meerstern/STM32_Nucleo144_Memory_Shield/img/img4.jpg

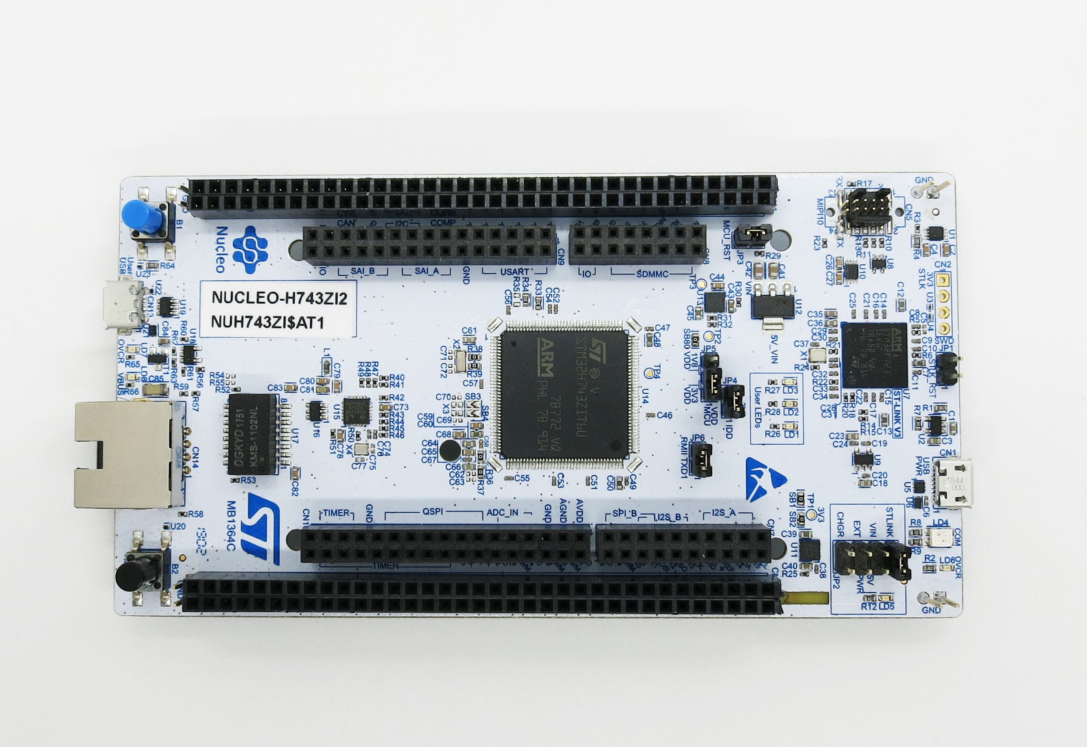
img/img4.jpg
