meerstern/STM32_Nucleo144_Memory_Shield/img2.jpg

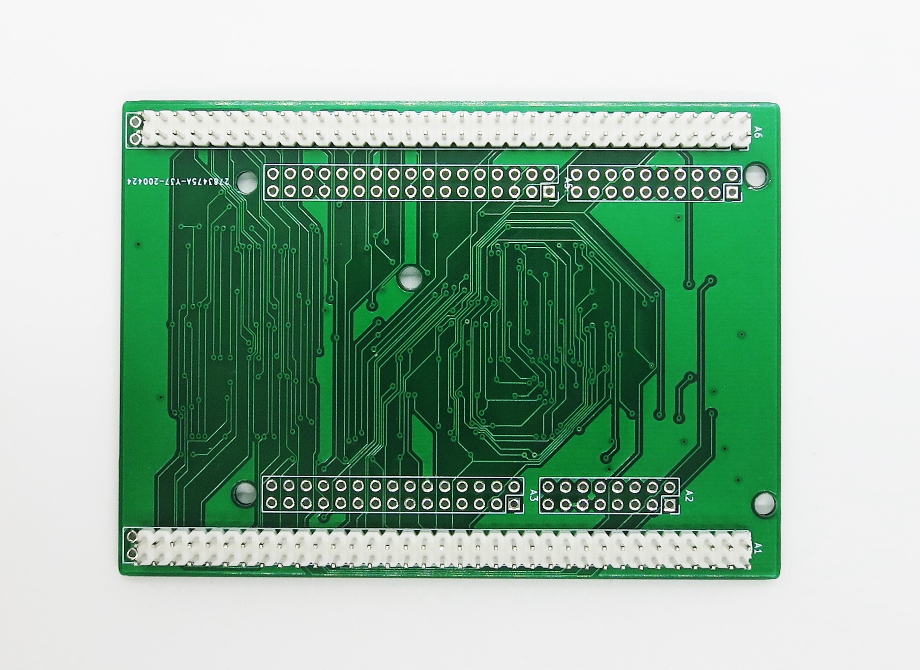
img2.jpg
