meerstern/STM32_Nucleo144_Memory_Shield/img1.jpg

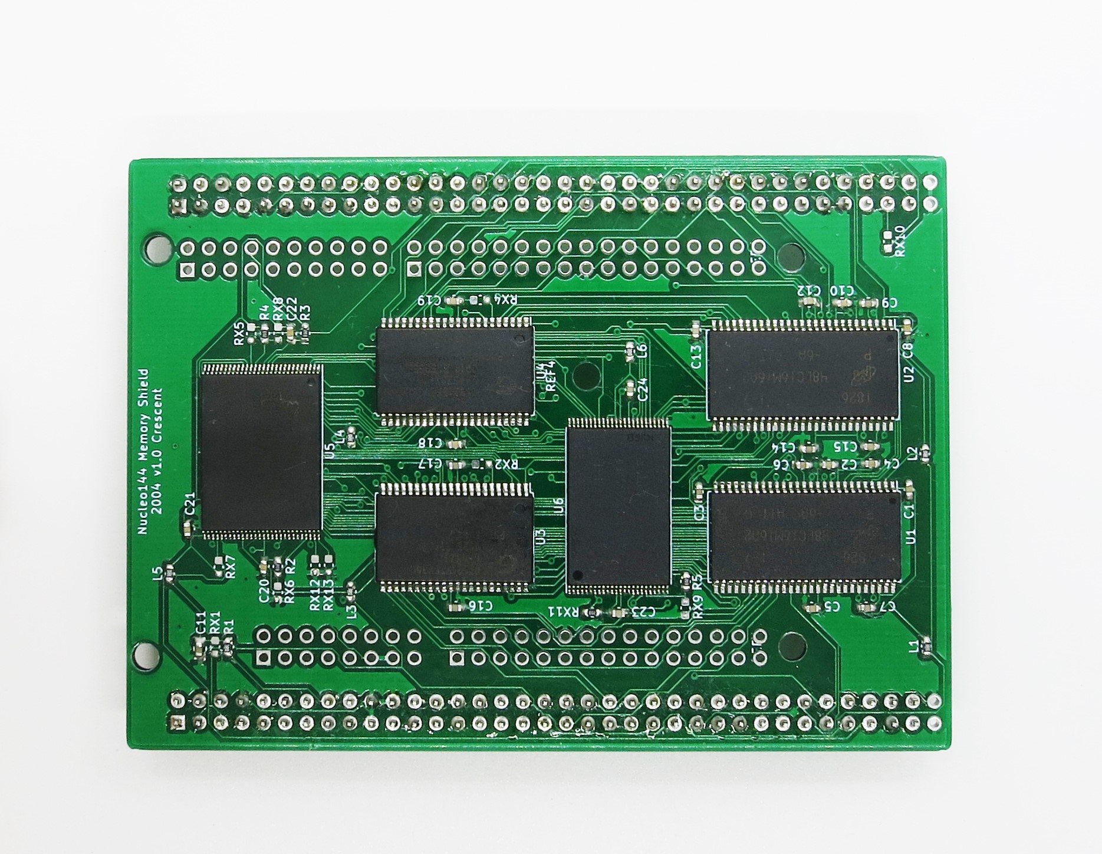
img1.jpg
