meerstern/STM32_Nucleo144_Memory_Shield/img/img1.jpg

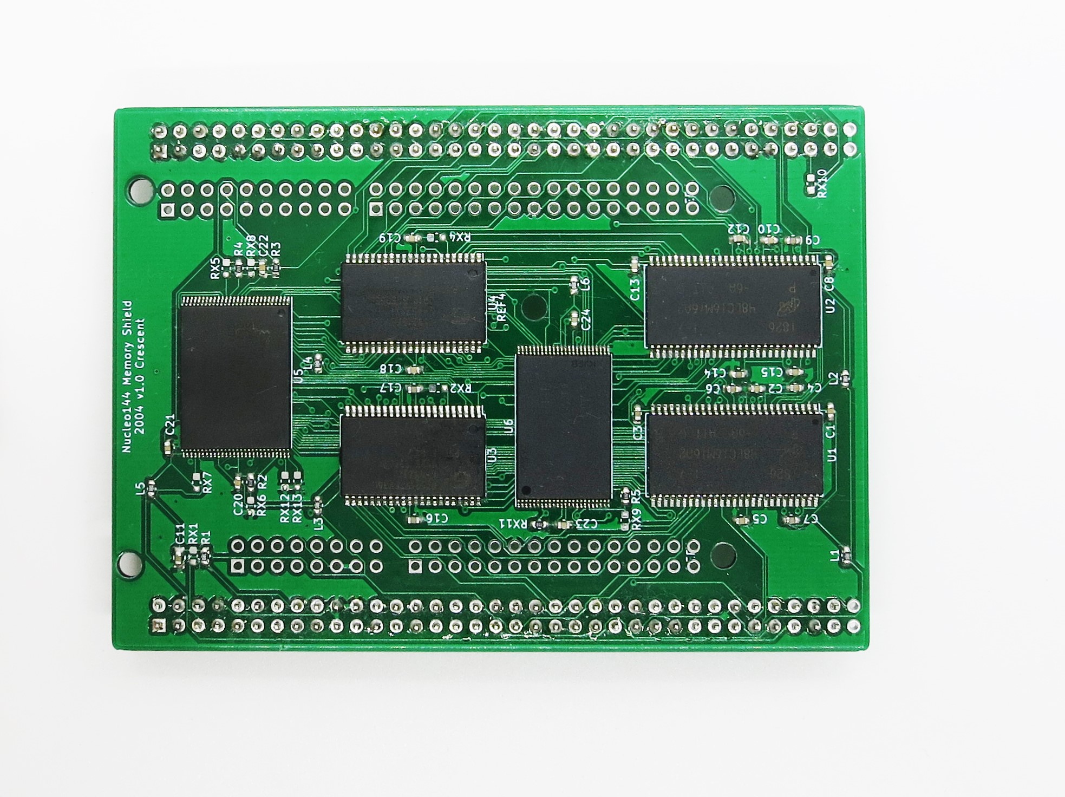
img/img1.jpg
