meerstern/STM32_Nucleo144_Memory_Shield/img/img2.jpg

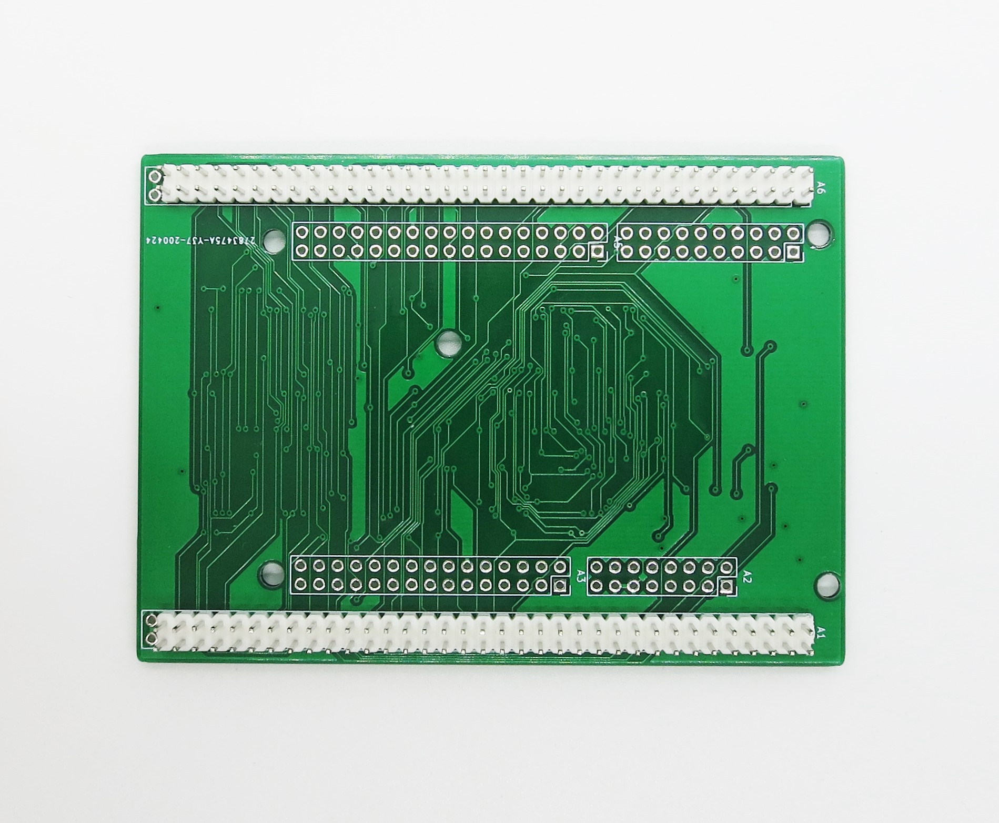
img/img2.jpg
