meerstern/STM32_Nucleo144_Memory_Shield/img/img3.jpg

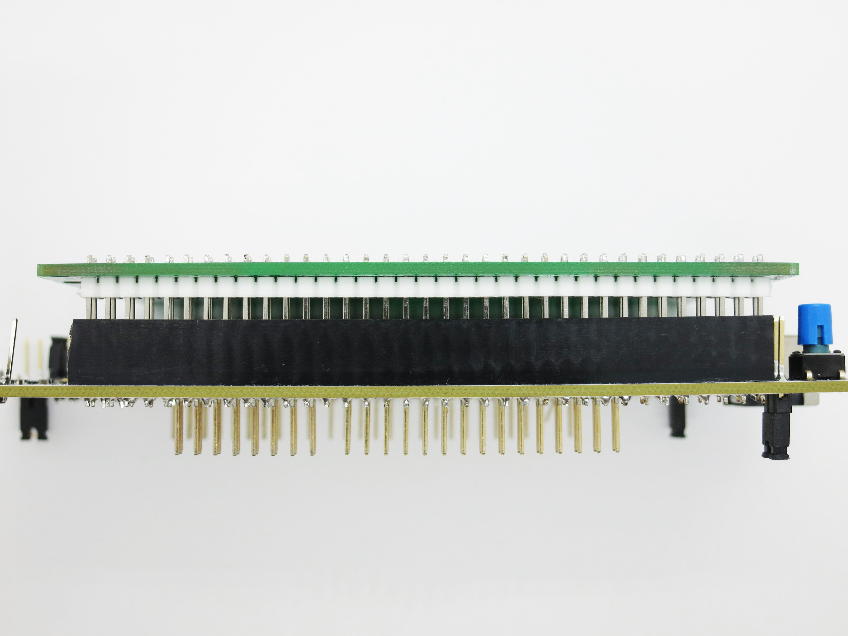
img/img3.jpg
