meerstern/STM32_Nucleo144_Memory_Shield/Circuit.pdf

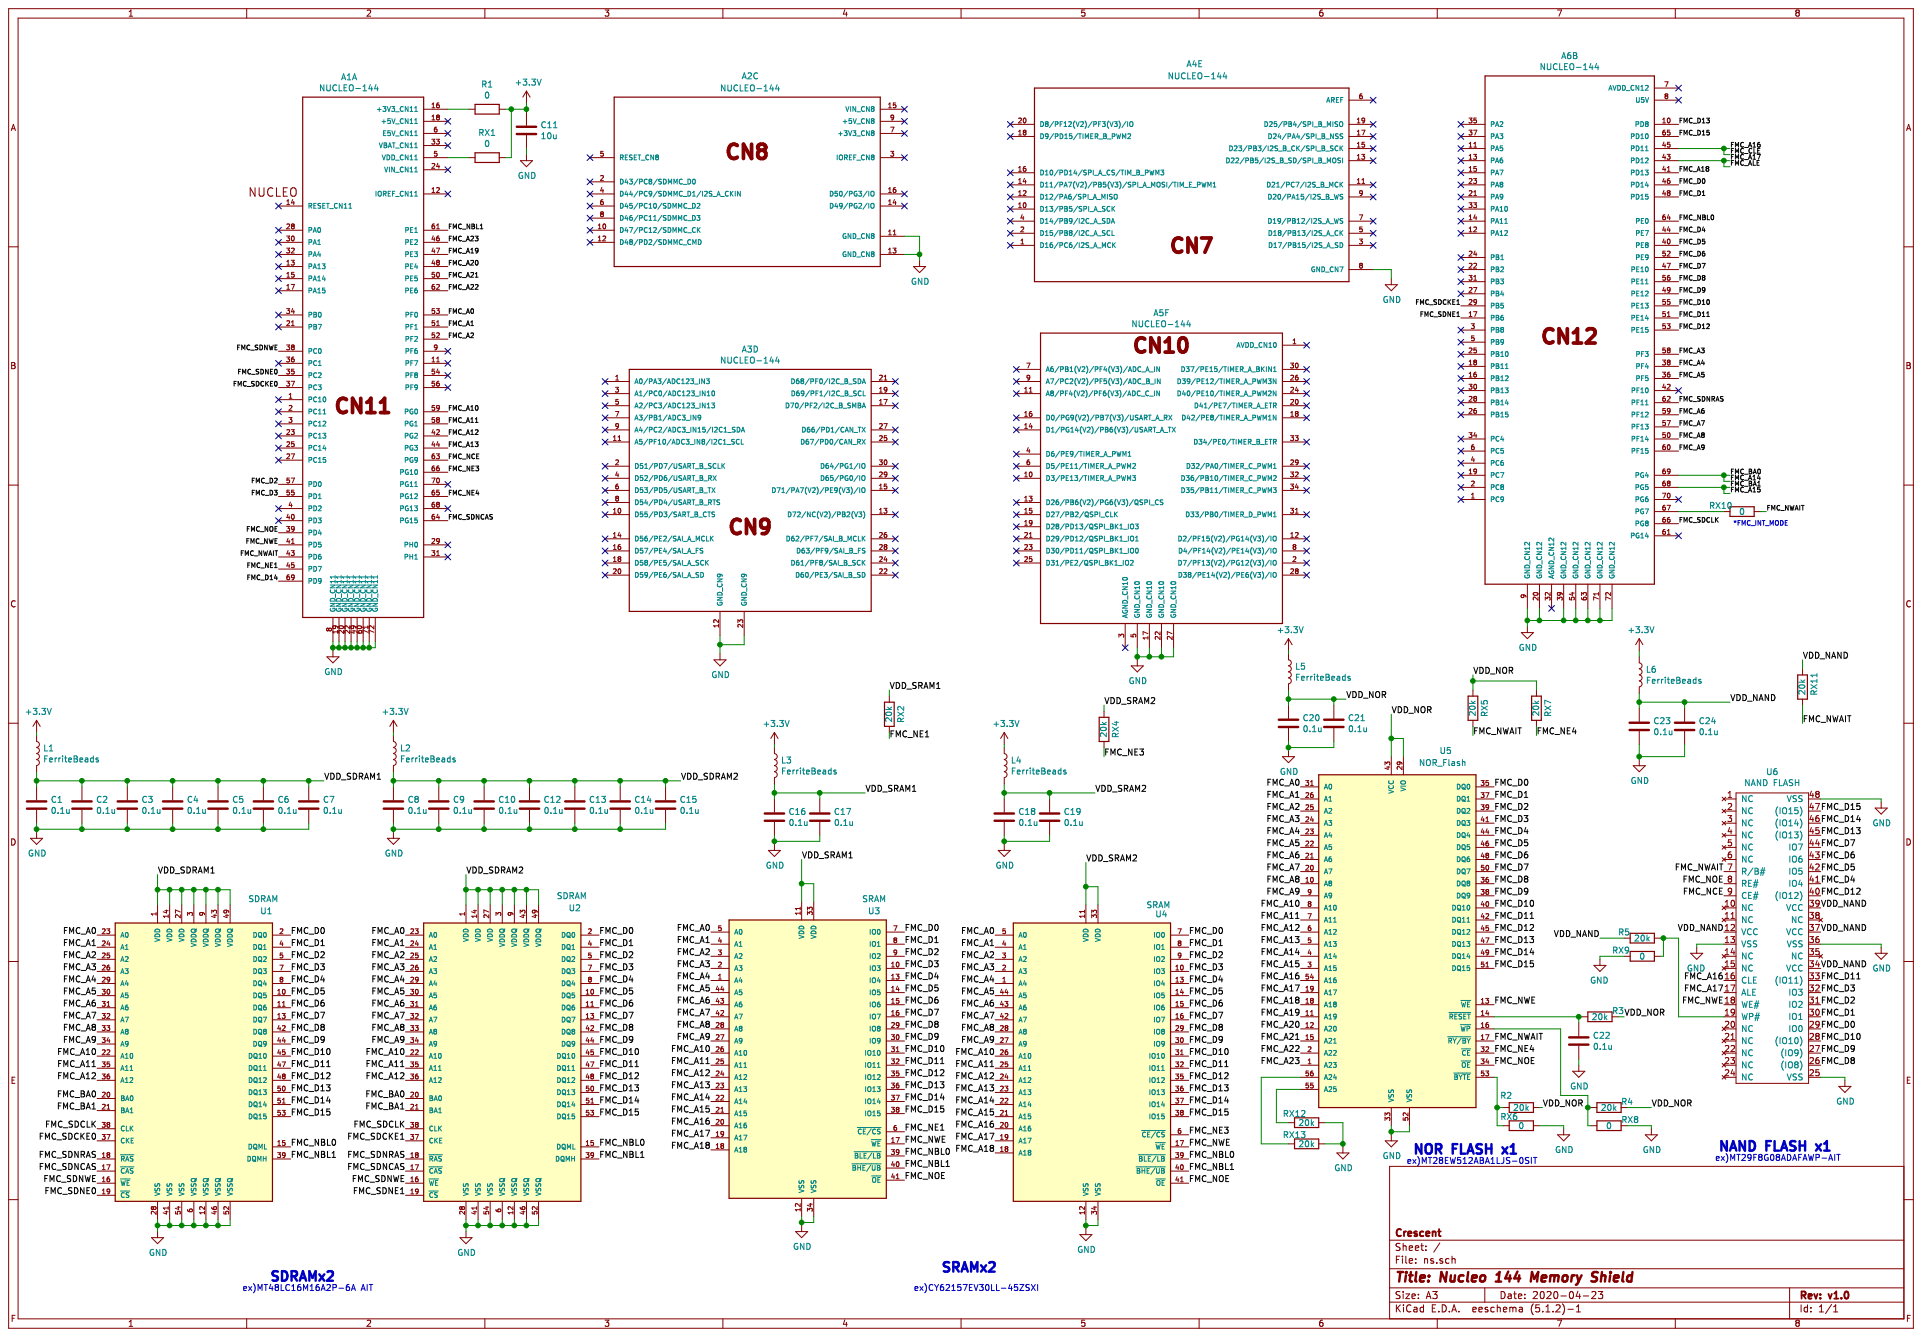
[picture p12: page 1]
