meerstern/STM32_Nucleo144_Memory_Shield/(list of files, drawings)

Other design files:
ns.dsn
