meerstern/STM32_Nucleo144_Memory_Shield/ns.kicad_pcb

## KiCad design ns.kicad_pcb (2020-06-07)

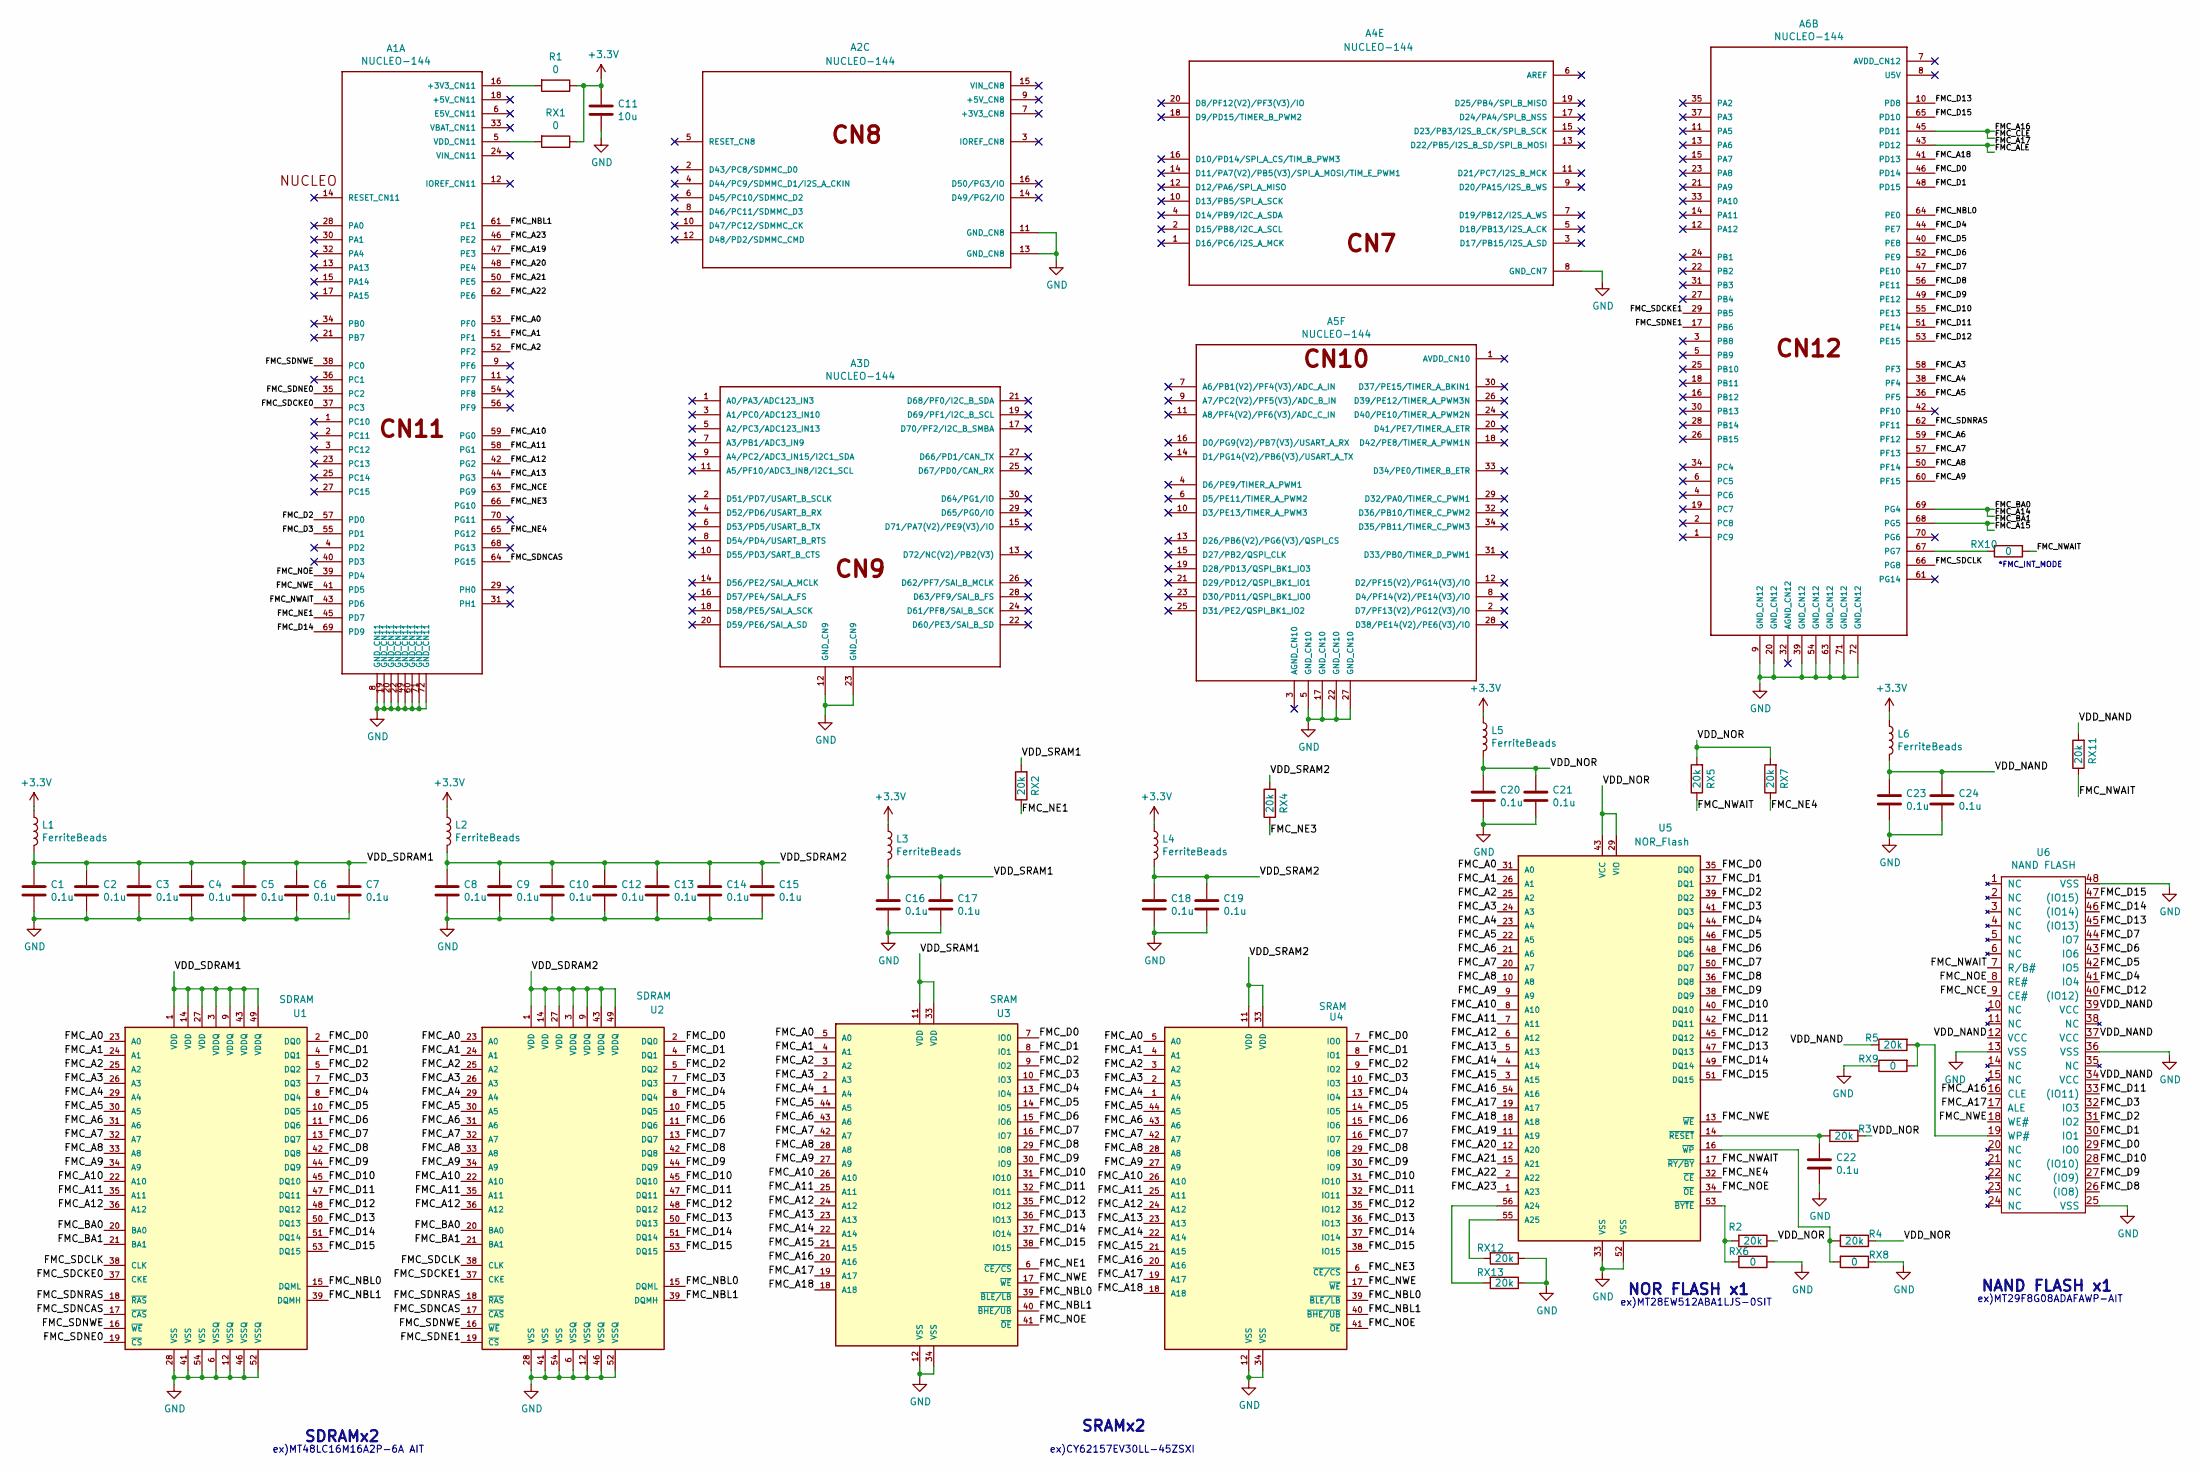
[picture p13: schematic ns.sch, Nucleo 144 Memory Shield]

Parts:
A1, A6: NUCLEO-144; PinSocket_2x36_P2.54mm_Vertical
A2: NUCLEO-144; PinSocket_2x08_P2.54mm_Vertical
A3: NUCLEO-144; PinSocket_2x15_P2.54mm_Vertical
A4: NUCLEO-144; PinSocket_2x10_P2.54mm_Vertical
A5: NUCLEO-144; PinSocket_2x17_P2.54mm_Vertical
C1, C2, C3, C4, C5, C6, C7, C8, C9, C10, C12, C13, C14, C15, C16, C17, C18, C19, C20, C21, C22, C23, C24: 0.1u; C_0603_1608Metric
C11: 10u; C_0805_2012Metric
L1, L2, L3, L4, L5, L6: FerriteBeads; L_0603_1608Metric
R1: 0; R_0603_1608Metric
R2, R3, R4, R5: 20k; R_0603_1608Metric
RX1, RX6, RX8, RX9, RX10: 0; R_0603_1608Metric
RX2, RX4, RX5, RX7, RX11, RX12, RX13: 20k; R_0603_1608Metric
U1, U2: SDRAM; TSOP-II-54_22.2x10.16mm_P0.8mm
U3, U4: SRAM; TSOP-II-44_10.16x18.41mm_P0.8mm
U5: NOR_Flash; TSOP-I-56_18.4x14mm_P0.5mm
U6: NAND FLASH; TSOP-I-48_18.4x12mm_P0.5mm

Connections:
+3V3: C11.1, L1.1, L2.1, L3.1, L4.1, L5.1, L6.1, R1.1, RX1.1
/FMC_A0: A1.53 (PF0), U1.23 (A0), U2.23 (A0), U3.5 (A0), U4.5 (A0), U5.31 (A0)
/FMC_A1: A1.51 (PF1), U1.24 (A1), U2.24 (A1), U3.4 (A1), U4.4 (A1), U5.26 (A1)
/FMC_A2: A1.52 (PF2), U1.25 (A2), U2.25 (A2), U3.3 (A2), U4.3 (A2), U5.25 (A2)
/FMC_A3: A6.58 (PG1), U1.26 (A3), U2.26 (A3), U3.2 (A3), U4.2 (A3), U5.24 (A3)
/FMC_A4: A6.38 (PC0), U1.29 (A4), U2.29 (A4), U3.1 (A4), U4.1 (A4), U5.23 (A4)
/FMC_A5: A6.36 (PC1), U1.30 (A5), U2.30 (A5), U3.44 (A5), U4.44 (A5), U5.22 (A5)
/FMC_A6: A6.59 (PG0), U1.31 (A6), U2.31 (A6), U3.43 (A6), U4.43 (A6), U5.21 (A6)
/FMC_A7: A6.57 (PD0), U1.32 (A7), U2.32 (A7), U3.42 (A7), U4.42 (A7), U5.20 (A7)
/FMC_A8: A6.50 (PE5), U1.33 (A8), U2.33 (A8), U3.28 (A8), U4.28 (A8), U5.10 (A8)
/FMC_A9: A6.60 (GND_CN11), U1.34 (A9), U2.34 (A9), U3.27 (A9), U4.27 (A9), U5.9 (A9)
/FMC_A10: A1.59 (PG0), U1.22 (A10), U2.22 (A10), U3.26 (A10), U4.26 (A10), U5.8 (A10)
/FMC_A11: A1.58 (PG1), U1.35 (A11), U2.35 (A11), U3.25 (A11), U4.25 (A11), U5.7 (A11)
/FMC_A12: A1.42 (PG2), U1.36 (A12), U2.36 (A12), U3.24 (A12), U4.24 (A12), U5.6 (A12)
/FMC_A13: A1.44 (PG3), U3.23 (A13), U4.23 (A13), U5.5 (A13)
/FMC_A14: A6.69 (PD9), U1.20 (BA0), U2.20 (BA0), U3.22 (A14), U4.22 (A14), U5.4 (A14)
/FMC_A15: A6.68 (PG13), U1.21 (BA1), U2.21 (BA1), U3.21 (A15), U4.21 (A15), U5.3 (A15)
/FMC_A16: A6.45 (PD7), U3.20 (A16), U4.20 (A16), U5.54 (A16), U6.16 (CLE)
/FMC_A17: A6.43 (PD6), U3.19 (A17), U4.19 (A17), U5.19 (A17), U6.17 (ALE)
/FMC_A18: A6.41 (PD5), U3.18 (A18), U4.18 (A18), U5.18 (A18)
/FMC_A19: A1.47 (PE3), U5.11 (A19)
/FMC_A20: A1.48 (PE4), U5.12 (A20)
/FMC_A21: A1.50 (PE5), U5.15 (A21)
/FMC_A22: A1.62 (PE6), U5.2 (A22)
/FMC_A23: A1.46 (PE2), U5.1 (A23)
/FMC_D0: A6.46 (PE2), U1.2 (DQ0), U2.2 (DQ0), U3.7 (IO0), U4.7 (IO0), U5.35 (DQ0), U6.29 (IO0)
/FMC_D1: A6.48 (PE4), U1.4 (DQ1), U2.4 (DQ1), U3.8 (IO1), U4.8 (IO1), U5.37 (DQ1), U6.30 (IO1)
/FMC_D2: A1.57 (PD0), U1.5 (DQ2), U2.5 (DQ2), U3.9 (IO2), U4.9 (IO2), U5.39 (DQ2), U6.31 (IO2)
/FMC_D3: A1.55 (PD1), U1.7 (DQ3), U2.7 (DQ3), U3.10 (IO3), U4.10 (IO3), U5.41 (DQ3), U6.32 (IO3)
/FMC_D4: A6.44 (PG3), U1.8 (DQ4), U2.8 (DQ4), U3.13 (IO4), U4.13 (IO4), U5.44 (DQ4), U6.41 (IO4)
/FMC_D5: A6.40 (PD3), U1.10 (DQ5), U2.10 (DQ5), U3.14 (IO5), U4.14 (IO5), U5.46 (DQ5), U6.42 (IO5)
/FMC_D6: A6.52 (PF2), U1.11 (DQ6), U2.11 (DQ6), U3.15 (IO6), U4.15 (IO6), U5.48 (DQ6), U6.43 (IO6)
/FMC_D7: A6.47 (PE3), U1.13 (DQ7), U2.13 (DQ7), U3.16 (IO7), U4.16 (IO7), U5.50 (DQ7), U6.44 (IO7)
/FMC_D8: A6.56 (PF9), U1.42 (DQ8), U2.42 (DQ8), U3.29 (IO8), U4.29 (IO8), U5.36 (DQ8), U6.26 ((IO8))
/FMC_D9: A6.49 (GND_CN11), U1.44 (DQ9), U2.44 (DQ9), U3.30 (IO9), U4.30 (IO9), U5.38 (DQ9), U6.27 ((IO9))
/FMC_D10: A6.55 (PD1), U1.45 (DQ10), U2.45 (DQ10), U3.31 (IO10), U4.31 (IO10), U5.40 (DQ10), U6.28 ((IO10))
/FMC_D11: A6.51 (PF1), U1.47 (DQ11), U2.47 (DQ11), U3.32 (IO11), U4.32 (IO11), U5.42 (DQ11), U6.33 ((IO11))
/FMC_D12: A6.53 (PF0), U1.48 (DQ12), U2.48 (DQ12), U3.35 (IO12), U4.35 (IO12), U5.45 (DQ12), U6.40 ((IO12))
/FMC_D13: A6.10 (PD8), U1.50 (DQ13), U2.50 (DQ13), U3.36 (IO13), U4.36 (IO13), U5.47 (DQ13), U6.45 ((IO13))
/FMC_D14: A1.69 (PD9), U1.51 (DQ14), U2.51 (DQ14), U3.37 (IO14), U4.37 (IO14), U5.49 (DQ14), U6.46 ((IO14))
/FMC_D15: A6.65 (PG12), U1.53 (DQ15), U2.53 (DQ15), U3.38 (IO15), U4.38 (IO15), U5.51 (DQ15), U6.47 ((IO15))
/FMC_NBL0: A6.64 (PG15), U1.15 (DQML), U2.15 (DQML), U3.39 (~BLE/LB~), U4.39 (~BLE/LB~)
/FMC_NBL1: A1.61 (PE1), U1.39 (DQMH), U2.39 (DQMH), U3.40 (~BHE/UB~), U4.40 (~BHE/UB~)
/FMC_NCE: A1.63 (PG9), U6.9 (CE#)
/FMC_NE1: A1.45 (PD7), RX2.1, U3.6 (~CE/CS~)
/FMC_NE3: A1.66 (PG10), RX4.1, U4.6 (~CE/CS~)
/FMC_NE4: A1.65 (PG12), RX7.1, U5.32 (~CE~)
/FMC_NOE: A1.39 (PD4), U3.41 (~OE~), U4.41 (~OE~), U5.34 (~OE~), U6.8 (RE#)
/FMC_NWAIT: A1.43 (PD6), RX5.1, RX10.2, RX11.1, U5.17 (~RY/BY~), U6.7 (R/B#)
/FMC_NWE: A1.41 (PD5), U3.17 (~WE~), U4.17 (~WE~), U5.13 (~WE~), U6.18 (WE#)
/FMC_SDCKE0: A1.37 (PC3), U1.37 (CKE)
/FMC_SDCKE1: A6.29 (PH0), U2.37 (CKE)
/FMC_SDCLK: A6.66 (PG10), U1.38 (CLK), U2.38 (CLK)
/FMC_SDNCAS: A1.64 (PG15), U1.17 (~CAS~), U2.17 (~CAS~)
/FMC_SDNE0: A1.35 (PC2), U1.19 (~CS~)
/FMC_SDNE1: A6.17 (PA15), U2.19 (~CS~)
/FMC_SDNRAS: A6.62 (PE6), U1.18 (~RAS~), U2.18 (~RAS~)
/FMC_SDNWE: A1.38 (PC0), U1.16 (~WE~), U2.16 (~WE~)
/VDD_NAND: C23.1, C24.1, L6.2, R5.1, RX11.2, U6.12 (VCC), U6.34 (VCC), U6.37 (VCC), U6.39 (VCC)
/VDD_NOR: C20.1, C21.1, L5.2, R2.1, R3.1, R4.1, RX5.2, RX7.2, U5.29 (VIO), U5.43 (VCC)
/VDD_SDRAM1: C1.1, C2.1, C3.1, C4.1, C5.1, C6.1, C7.1, L1.2, U1.1 (VDD), U1.3 (VDDQ), U1.9 (VDDQ), U1.14 (VDD), U1.27 (VDD), U1.43 (VDDQ), U1.49 (VDDQ)
/VDD_SDRAM2: C8.1, C9.1, C10.1, C12.1, C13.1, C14.1, C15.1, L2.2, U2.1 (VDD), U2.3 (VDDQ), U2.9 (VDDQ), U2.14 (VDD), U2.27 (VDD), U2.43 (VDDQ), U2.49 (VDDQ)
/VDD_SRAM1: C16.1, C17.1, L3.2, RX2.2, U3.11 (VDD), U3.33 (VDD)
/VDD_SRAM2: C18.1, C19.1, L4.2, RX4.2, U4.11 (VDD), U4.33 (VDD)
GND: A1.8 (GND_CN11), A1.19 (GND_CN11), A1.20 (GND_CN11), A1.22 (GND_CN11), A1.49 (GND_CN11), A1.60 (GND_CN11), A1.71 (GND_CN11), A1.72 (GND_CN11), A2.11 (PF7), A2.13 (PA13), A3.12 (IOREF_CN11), A3.23 (PC13), A4.8 (GND_CN11), A5.5 (VDD_CN11), A5.17 (PA15), A5.22 (GND_CN11), A5.27 (PC15), A6.9 (PF6), A6.20 (GND_CN11), A6.39 (PD4), A6.54 (PF8), A6.63 (PG9), A6.71 (GND_CN11), A6.72 (GND_CN11), C1.2, C2.2, C3.2, C4.2, C5.2, C6.2, C7.2, C8.2, C9.2, C10.2, C11.2, C12.2, C13.2, C14.2, C15.2, C16.2, C17.2, C18.2, C19.2, C20.2, C21.2, C22.2, C23.2, C24.2, RX6.1, RX8.1, RX9.1, RX12.1, RX13.1, U1.6 (VSSQ), U1.12 (VSSQ), U1.28 (VSS), U1.41 (VSS), U1.46 (VSSQ), U1.52 (VSSQ), U1.54 (VSS), U2.6 (VSSQ), U2.12 (VSSQ), U2.28 (VSS), U2.41 (VSS), U2.46 (VSSQ), U2.52 (VSSQ), U2.54 (VSS), U3.12 (VSS), U3.34 (VSS), U4.12 (VSS), U4.34 (VSS), U5.33 (VSS), U5.52 (VSS), U6.13 (VSS), U6.25 (VSS), U6.36 (VSS), U6.48 (VSS)
unnamed: A1.5 (VDD_CN11), RX1.2
unnamed: A1.16 (+3V3_CN11), R1.2
unnamed: A6.67 (PG7), RX10.1
unnamed: C22.1, R3.2, U5.14 (~RESET~)
unnamed: R2.2, RX6.2, U5.53 (~BYTE~)
unnamed: R4.2, RX8.2, U5.16 (~WP~)
unnamed: R5.2, RX9.2, U6.19 (WP#)
unnamed: RX12.2, U5.55 (A25)
unnamed: RX13.2, U5.56 (A24)

Notes on the sheet:
SDRAMx2
SRAMx2
NOR FLASH x1
NAND FLASH x1
*FMC_INT_MODE
ex)CY62157EV30LL-45ZSXI
ex)MT28EW512ABA1LJS-0SIT
ex)MT29F8G08ADAFAWP-AIT
ex)MT48LC16M16A2P-6A AIT

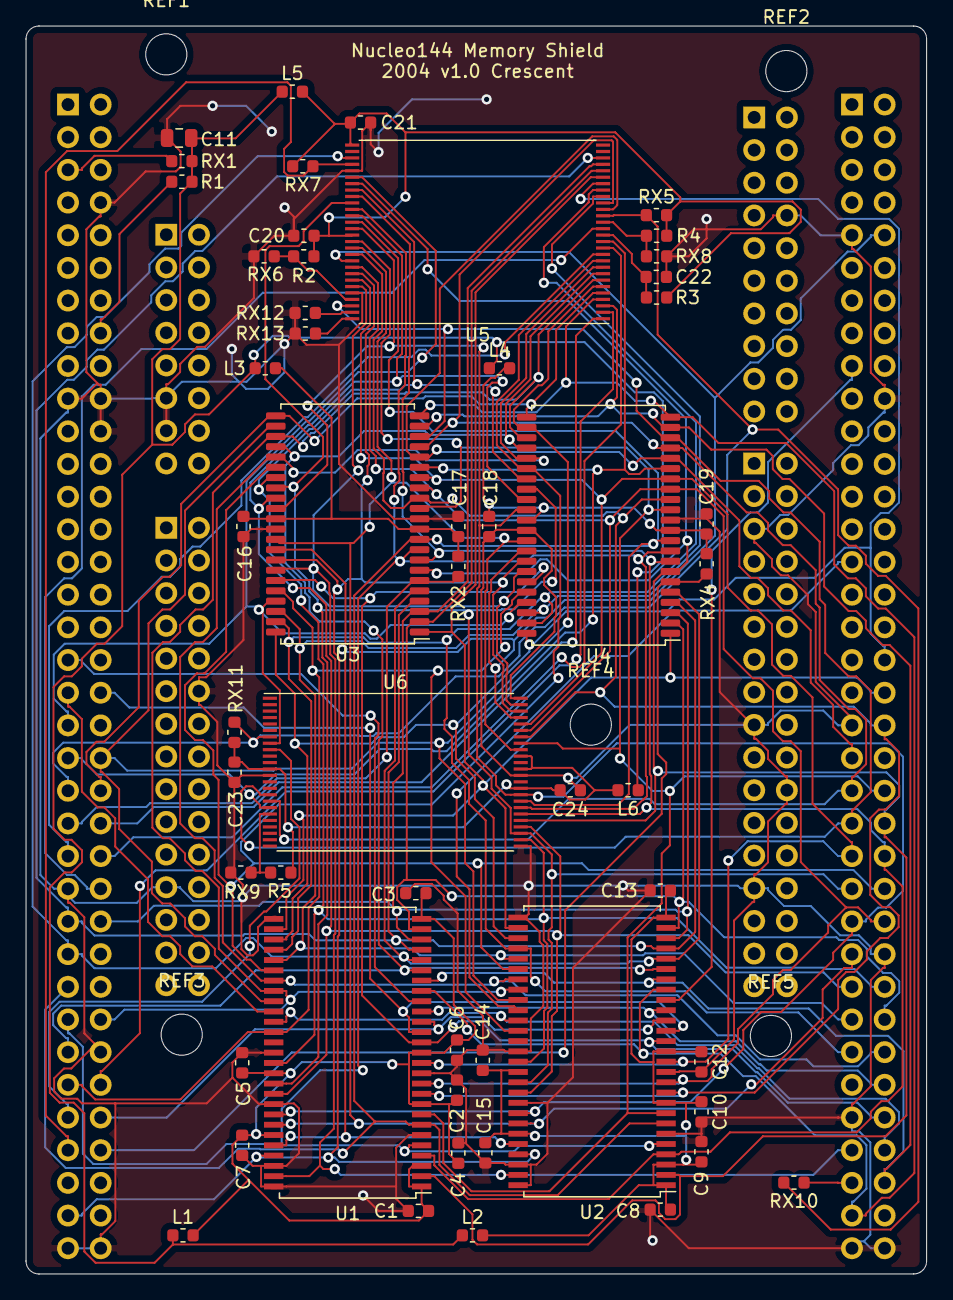
[picture p14: board ns.kicad_pcb from above]

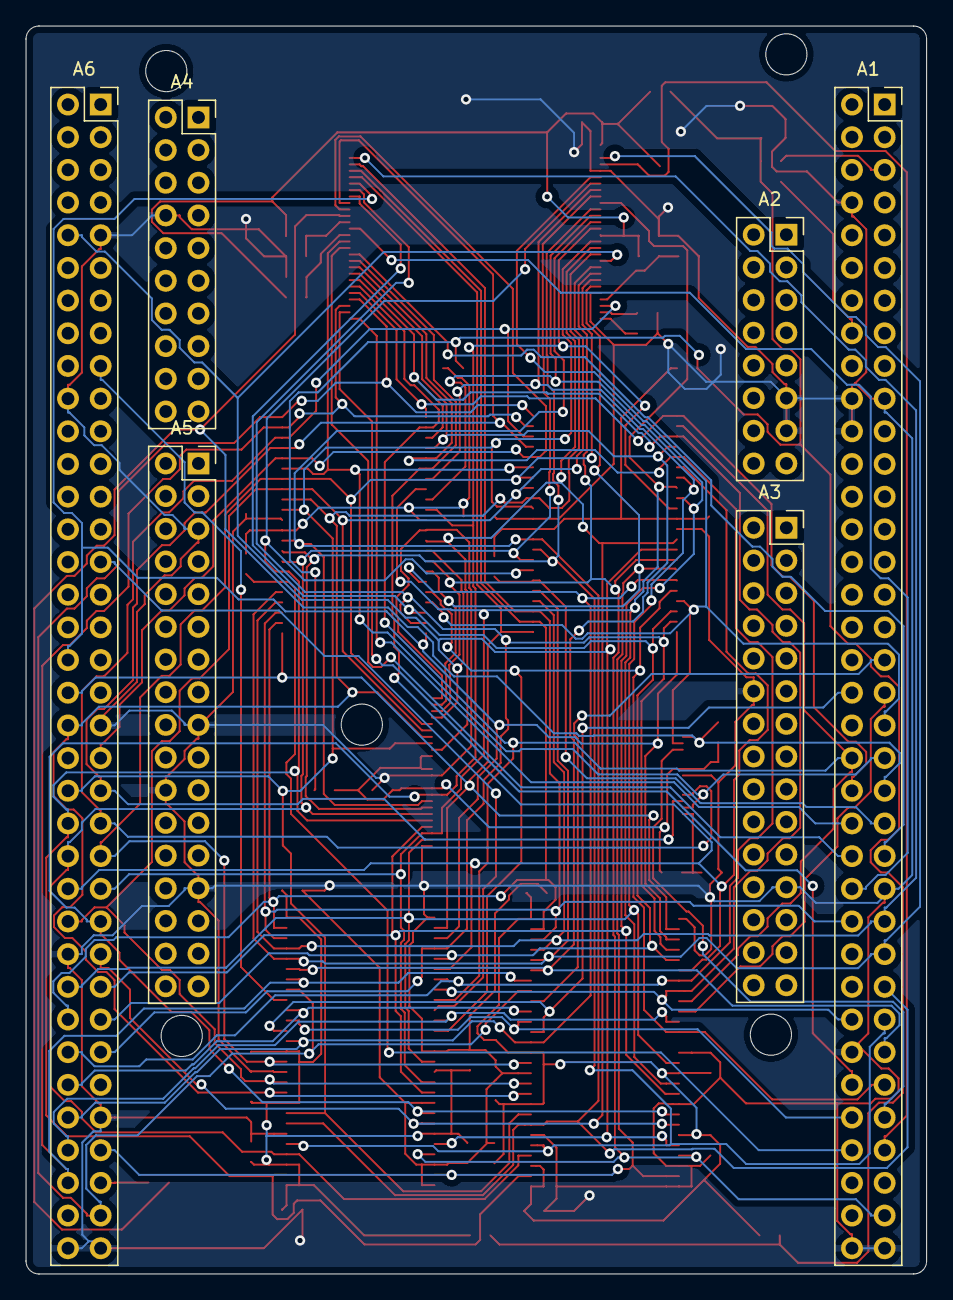
[picture p15: board ns.kicad_pcb from below]

Board: 2 copper layers, 70.0 x 97.0 mm, 64 parts (6 on the bottom side), 74 nets.

Other parts of the board:
REF1, REF2, REF3, REF4, REF5: MountingHole_3.2mm_M3
