meerstern/STM32_Nucleo144_Memory_Shield/STM32H743_MEMORY/STM32H743_MEMORY_SDRAM.ioc

Mcu.UserName=STM32H743ZITx
PA1.Signal=ETH_REF_CLK
PA11.Signal=USB_OTG_FS_DM
PA12.Signal=USB_OTG_FS_DP
PA2.Signal=ETH_MDIO
PA7.Signal=ETH_CRS_DV
PA8.Signal=USB_OTG_FS_SOF
PA9.Signal=USB_OTG_FS_VBUS
PB0.GPIO_Label=LD1 [Green Led]
PB0.Signal=GPIO_Output
PB10.Signal=USART3_TX
PB11.Signal=USART3_RX
PB13.Signal=ETH_TXD1
PB14.GPIO_Label=LD3 [Red Led]
PB14.Signal=GPIO_Output
PB5.Signal=FMC_SDCKE1
PB6.Signal=FMC_SDNE1
PC0.Signal=FMC_SDNWE
PC1.Signal=ETH_MDC
PC13.GPIO_Label=B1 [Blue PushButton]
PC13.Signal=GPIO_Input
PC2_C.Signal=FMC_SDNE0
PC3_C.Signal=FMC_SDCKE0
PC4.Signal=ETH_RXD0
PC5.Signal=ETH_RXD1
PD0.Signal=FMC_D2_DA2
PD1.Signal=FMC_D3_DA3
PD10.Signal=FMC_D15_DA15
PD11.Signal=FMC_A16_CLE
PD12.Signal=FMC_A17_ALE
PD13.Signal=FMC_A18
PD14.Signal=FMC_D0_DA0
PD15.Signal=FMC_D1_DA1
PD4.Signal=FMC_NOE
PD5.Signal=FMC_NWE
PD6.Signal=FMC_NWAIT
PD7.Signal=FMC_NE1
PD8.Signal=FMC_D13_DA13
PD9.Signal=FMC_D14_DA14
PE0.Signal=FMC_NBL0
PE1.Signal=FMC_NBL1
PE10.Signal=FMC_D7_DA7
PE11.Signal=FMC_D8_DA8
PE12.Signal=FMC_D9_DA9
PE13.Signal=FMC_D10_DA10
PE14.Signal=FMC_D11_DA11
PE15.Signal=FMC_D12_DA12
PE2.Signal=FMC_A23
PE3.Signal=FMC_A19
PE4.Signal=FMC_A20
PE5.Signal=FMC_A21
PE6.Signal=FMC_A22
PE7.Signal=FMC_D4_DA4
PE8.Signal=FMC_D5_DA5
PE9.Signal=FMC_D6_DA6
PF0.Signal=FMC_A0
PF1.Signal=FMC_A1
PF11.Signal=FMC_SDNRAS
PF12.Signal=FMC_A6
PF13.Signal=FMC_A7
PF14.Signal=FMC_A8
PF15.Signal=FMC_A9
PF2.Signal=FMC_A2
PF3.Signal=FMC_A3
PF4.Signal=FMC_A4
PF5.Signal=FMC_A5
PG0.Signal=FMC_A10
PG1.Signal=FMC_A11
PG10.Signal=FMC_NE3
PG11.Signal=ETH_TX_EN
PG12.Signal=FMC_NE4
PG13.Signal=ETH_TXD0
PG15.Signal=FMC_SDNCAS
PG2.Signal=FMC_A12
PG3.Signal=FMC_A13
PG4.Signal=FMC_A14_BA0
PG5.Signal=FMC_A15_BA1
PG8.Signal=FMC_SDCLK
PG9.Signal=FMC_NCE
