meerstern/STM32_Nucleo144_Memory_Shield/(commit log)

2020-06-07 Add PCB data
    [ns-B_Cu.gbl, ns-B_Mask.gbs, ns-B_Paste.gbp, ns-B_SilkS.gbo, ns-F_Cu.gtl, ns-F_Mask.gts, ns-F_Paste.gtp, ns-F_SilkS.gto]
2020-09-20 Add sample code with CubeMX
    [FMC.xlsx]
